antonysigma/piezo-stage-pid-board/control_model/root_locus_dt.png

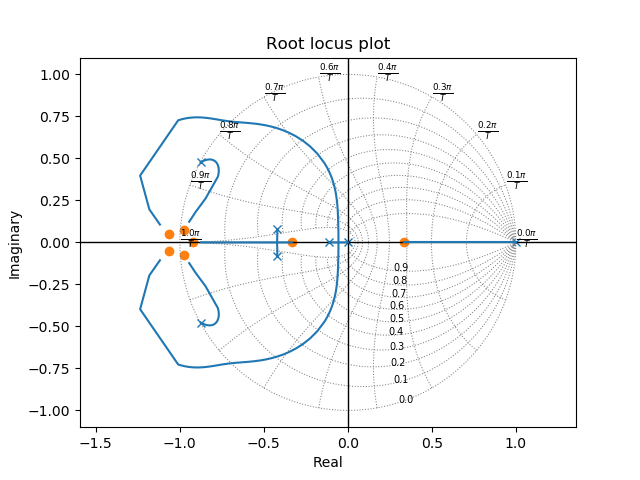
control_model/root_locus_dt.png
