antonysigma/piezo-stage-pid-board/(list of files, drawings)

Other design files:
schematic/galvo-arduino.pcb
