antonysigma/piezo-stage-pid-board/(commit log)

2018-05-11 schematic for piezo driver control
    [galvo-arduino-page1.sch]
2018-05-18 New low-pass filter circuit
    [galvo-arduino-page1.sch]
2018-05-26 Add component footprint, value and the Vender number
    [galvo-arduino-page1.sch]
2018-05-26 Add footprints
2018-05-26 New coaxial connector footprint
2018-05-26 Footprint for CPolar100
2018-05-29 Replace opamp with comparator; add current limiting resistor to LEDs; add FTDI_boot
    [galvo-arduino-page1.sch]
2018-05-31 Set voltage reference to +4.0V; Add pull up resistor
    [galvo-arduino-page1.sch]
2018-06-12 Update part number
    [galvo-arduino-page1.sch]
2018-06-12 Arrange the components
    [galvo-arduino-page1.sch, galvo-arduino.pcb]
2018-06-12 Complete PCB layout
    [galvo-arduino-page1.sch, galvo-arduino.pcb]
2018-07-25 M3 holes
2018-07-25 Fix D-sub footprint error; change bias voltage
    [galvo-arduino-page1.sch, galvo-arduino.pcb]
2023-05-02 Add Readme; move schematic to subfolder
    [galvo-arduino-page1.sch, galvo-arduino.pcb]
2023-05-02 Major revamp of the firmware
    Configure the MCU in multi-master mode, having i2c address of 0x09.
    Constexpr everythting. Use C++14 member initializer. Implement array
    delete.
2023-05-03 Add oscilloscope trace
2023-05-05 Implement lock LED with state machine logic
    Describe the Lock LED behavior in Mealy-style state transition logic.
    Ensure the close loop error is less than threshold for more than 50
    millisecond.
    [PIDcontrol.h]
2023-05-05 Implement alarm LED state transition logic
    Given the new system input value, sound the alarm if the input has
    reached the limit.
2023-05-08 Optimize for LTO
    * Use branch dispatcher in SML; store n_debounce in state variable
    * setup LED outside state machine
    * Define state machines in the header-only file
    * Improve LTO by moving all global objects to stack space in main()
    * Avoid polluting the global namespace
    [PIDcontrol.h, config.h, main.cpp]
2023-05-17 Replace two complex zeros with two real poles
    Intead of pulling the root locus of the 250Hz poles to 100Hz with two
    zeros on the j*omega axis, we add two poles on the negative real axis.
    This forces the 250Hz root locus to the left half plane.
    The new poles has a branch cut, passing the desired domainating pole
    position (0.68 damping, ~100Hz oscillation freq). It is conditionally
    stable with gain < 1e9, so please use it with caution.
2025-02-06 Implement i2c
2025-02-06 Implement actuator
2025-02-06 Implement linear encoder reset logic
    [callbacks.hpp]
2025-02-06 Resolve missing callback MoveTo
    [callbacks.hpp]
2025-02-06 Compile pid-controller
2025-02-07 Link PIDControl to dac_command and encoder_readout structs for now
2025-02-07 Download Encoder library from Github
2025-02-07 Deferred linear encoder readout
2025-02-08 Partial dependency injection with PIN numbers
2025-02-08 Dependency injection of Z travel range; avoid indirection of SetDesiredSystemOutput
    [callbacks.hpp, config.h, main.cpp, pid-controller.cpp, pid-controller.h]
2025-02-08 Dependency injection for encoder
2025-02-08 Avoid indirection when calling ZStage commands
    [callbacks.hpp, main.cpp]
2025-02-08 Linear encoder should be a controller, not a component
2025-02-08 Avoid out-of-class definition of static members
    [main.cpp]
2025-02-11 PEG script to extract runtime init flow action
    Scan all `*.hpp` files in the `components/` folder. For each file, parse
    the C++ code to look for instances of `cib::extends<RuntimeInit>( ...
    )`. Extract all flows `abc >> def`. Export the direct acyclic graph via
    GraphViz.
