antonysigma/piezo-stage-pid-board/(notices)

Notices in the files:
README.md:
alt="Creative Commons License" style="border-width:0"
src="https://i.creativecommons.org/l/by-sa/4.0/88x31.png" />
